aashishvanand/Mini-Flightwall/case/mini_flightwall_case_assembly.step

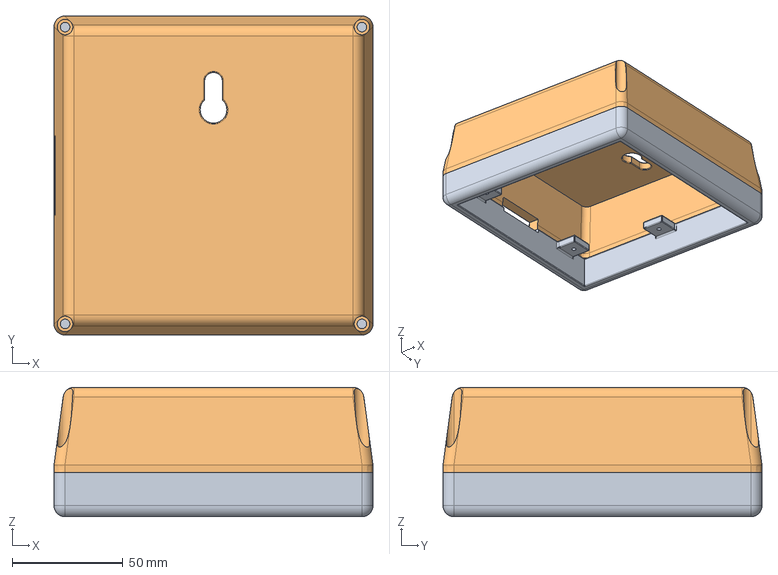
[picture p1: CAD file, 2026-10-03]
case/mini_flightwall_case_assembly.step
143.9 x 143.9 x 58.4 mm
