aashishvanand/Mini-Flightwall/case/mini_flightwall_case_back.step

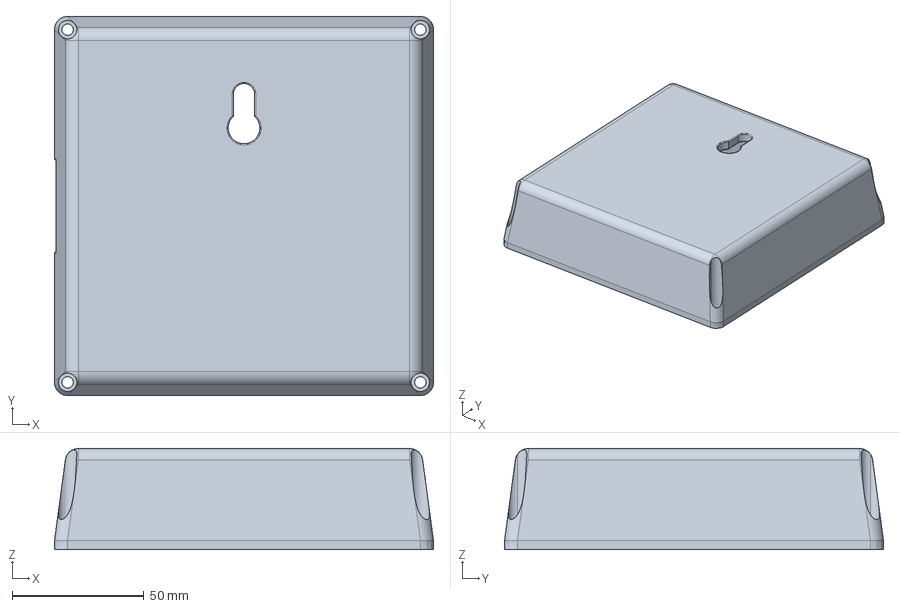
[picture p2: CAD file, 2026-10-03]
case/mini_flightwall_case_back.step
143.9 x 143.9 x 38.4 mm
