aashishvanand/Mini-Flightwall/case/mini_flightwall_case_front.step

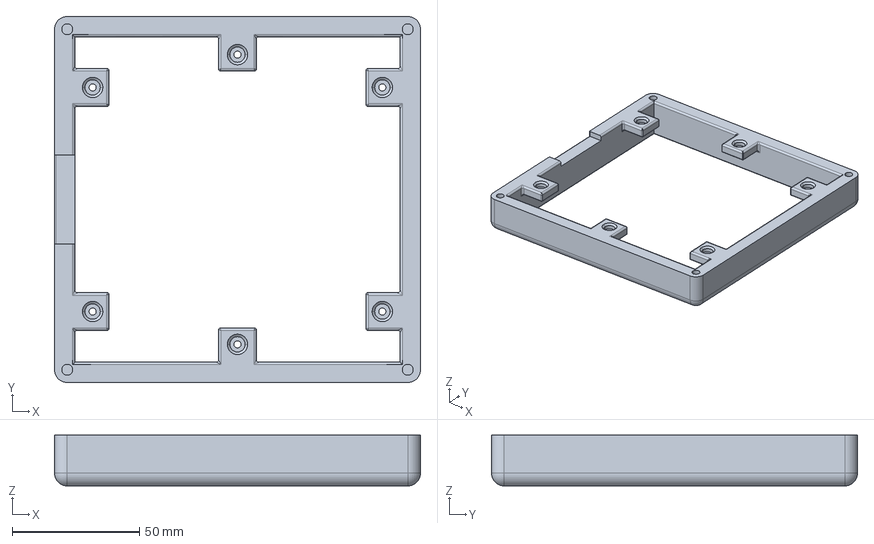
[picture p3: CAD file, 2026-10-03]
case/mini_flightwall_case_front.step
143.9 x 143.9 x 20.0 mm
