aashishvanand/Mini-Flightwall/(commit log)

2026-08-11 feat: add clipped scrolling for make/model text to prevent icon overlap
    [03_aircraft_display.ino]
2026-09-20 feat: switch to SGT, add matrix as third push target on shared workflow
    - Firmware: NTP fallback clock timezone from IST to SGT (UTC+8) — the
    panel is now deployed in Singapore, not Chennai.
    - .gitignore: explicitly ignore .env (was untracked but not covered).
    - README: document that the live feeder no longer runs this repo's
    standalone matrix64_aircraft_workflow.json in isolation — the matrix
    is now a third push branch on the shared Ulanzi Feeder n8n workflow
    (Lookup Aircraft (adsbdb) -> Build Payload (Matrix64) -> Push/Clear
    Matrix), reusing that workflow's dual-source OpenSky+FR24 positioning
    and route verification instead of duplicating a second poll against
    the same Op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
    [03_aircraft_display.ino]
2026-09-20 feat: regenerate all 319 icons with emblem-focus cropping
    Ports the Ulanzi Feeder repo's 8x8 AWTRIX converter (emblem-focus
    detection, unsharp masking, two-pass downscale, no-dither quantization)
    into this repo's 24x24 raw565 writer -- same source images
    (TailFin/tailfin/), same 319 codes, same output contract (<code>_logo.bin,
    1152 bytes each), just a smarter crop before the resize.
    Spot-checked SQ/CX/MH/AI against the old letterboxed output: the emblem
    mark fills noticeably more of the tile with punchier color in every case.
    Also pushed the regenerated set to the R2 bucket (tailfin/24x24) via
    tools/sync_icons_r2.sh so the live board picks it up on its next reboot
    or icon-sync interval, w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
2026-09-20 feat: admin web console, OTA updates, icon web upload, board/partition fixes
    Firmware (matrix64/03_aircraft_display):
    - Fixed useBuiltinCACertBundle() (esp32 core >=3.x removed the single-arg
    setCACertBundle() overload this used to call) -- was a hard compile
    error on current core versions.
    - Icon lookup cached per-push instead of re-scanning ~319 names every
    ~25ms scroll frame; re-resolved safely after a periodic icon sync so it
    never reads a freed pointer.
    - Non-blocking WiFi auto-reconnect in loop() -- previously a dropped
    connection left the board unreachable until power-cycled by hand.
    - NTP timezone resolved automatically at boot via IP-geolocation
    (api.ipify.org + timeapi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
    [03_aircraft_display.ino]
2026-09-20 fix: revert city row to 6x8 font, distribute leftover space as gaps
    The 2x-size city row (from the previous "fill the dead space at the
    bottom" fix) looked disproportionately large next to the rest of the
    display's uniform 6x8 text. Reverted to size-1.
    Instead of one dead gap (original layout) or one oversized row (previous
    fix), the panel's 8px of leftover vertical space (56px of actual content
    on a 64px panel) is now spent as four 2px SECTION_GAP gaps between the
    five content sections -- airline / flight+alt / icon block / IATA / city
    -- landing city's last row exactly on the panel's bottom edge either way.
    [03_aircraft_display.ino]
2026-09-21 feat: ground speed, climb/descend indicator, multi-aircraft rotation
    Firmware: flight/altitude line now also shows ground speed and a
    climb/descend indicator ("^"/"v", ASCII-only -- default GFX font has no
    unicode glyphs -- omitted within +-200ft/min of level). Both fields are
    optional in the payload; null/absent just omits that part of the line.
    n8n workflow (Ulanzi - Aircraft Overhead (SIN), updated live via the API,
    not stored in this repo -- see matrix64_aircraft_workflow.json for the
    standalone template, not touched here since it's not the live/tested
    path):
    - Nearest Aircraft: extracts velocity/vertical_rate from both position
    feeds (OpenSky's are in m/s, converted to kt/ft-min; FR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
2026-09-21 feat: watchdog, OTA rollback, stale-data fallback, auth, night mode, boot diagnostics
    Six reliability/operational improvements to the firmware, all
    compile-verified via arduino-cli:
    1. Stale-data fallback: falls back to the clock if no /api/display push
    arrives for 5 minutes -- previously the panel would show a long-gone
    aircraft forever if n8n stopped pushing, with no indication anything
    was wrong. A routine /api/clear (no aircraft in range) counts as
    contact and doesn't trigger this, only true silence does -- fixed in
    review after the first version misreported "none yet this boot" on a
    perfectly healthy board during a quiet period.
    2. OTA rollback safety: since arduino-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
    [03_aircraft_display.ino]
2026-10-03 feat: add 3D case models, airline icon assets, and n8n workflow tools
2026-10-03 feat: add enclosure STEP files, airline icons, and icon import tooling
